Keitark/tangnano4k-videoin/tb/tb_monochrome_gain.v

`timescale 1ns/1ps
module tb_monochrome_gain;
    reg clk=0, reset=1, hs=0;
    reg [7:0] level=64;
    wire valid;
    wire [15:0] rgb;
    integer n, checked;
    always #5 clk=~clk;
    ntsc_color_decoder #(.ENABLE_COLOR(0), .REQUIRE_FIELD_WINDOW(0),
        .FIXED_BLACK_LEVEL(64), .LUMA_GAIN_SHIFT(2)) dut (
        .clk(clk), .reset(reset), .sample_level(level), .hsync_pulse(hs),
        .vsync_pulse(1'b0), .pixel_valid(valid), .pixel_rgb565(rgb));
    task check_level;
        input [7:0] value;
        input [15:0] expected;
        begin
            @(negedge clk); reset=1; level=value;
            repeat(4) @(negedge clk);
            reset=0; hs=1;
            @(negedge clk); hs=0;
            checked=0;
            for(n=0;n<800;n=n+1) begin
                @(negedge clk);
                if(valid && n>100) begin
                    if(rgb !== expected) $fatal(1,"gain/clipping value=%d rgb=%h expected=%h",value,rgb,expected);
                    checked=checked+1;
                end
            end
            if(checked<500) $fatal(1,"not enough pixels");
        end
    endtask
    initial begin
        check_level(40,16'h0000);
        check_level(64,16'h0000);
        // Settled IIR truncation can put luminance one code below its target.
        // Choose exact constant gray after reset by forcing only filter state.
        force dut.luma_q4 = 13'sd1536;
        check_level(96,16'h8410);
        release dut.luma_q4;
        check_level(200,16'hffdf);
        $display("PASS gain4 black, gray, underflow and white clipping");
        $finish;
    end
endmodule
