Keitark/tangnano4k-videoin/(commit log)

2026-09-13 Import verified three-line NTSC color prototype
    Refs #1. Preserve hardware sources and programming policy; add curated evidence, current build instructions and a real-footage README banner.
2026-09-13 Document working AC-coupled video front end (#3)
    Refs #2. Add circuit, six-passive BOM, owner-confirmed 33 pF, exact nets and safety boundaries without changing HDL.
2026-09-14 docs: reference Lattice simple sigma-delta ADC design
2026-09-14 docs: compare Lattice ADC and video implementation
2026-09-14 docs: lead with Lattice-style ADC circuit block diagram
